NurzhanSeitzhanov/Not-a-Drone_Big-Data/README.md

# Not a Drone – Brand­erkennungs­prototyp

Dieses Projekt ist ein Prototyp auf Basis eines **ESP32-S3 Mikrocontrollers**, der eine Kamera, eine LED und einen Motor kombiniert, um feuerähnliche Farben zu erkennen. Das System bietet eine visuelle Rückmeldung über die LED, eine mechanische Reaktion durch den Motor sowie eine detaillierte Ausgabe über die serielle Schnittstelle.

---

## Wichtiger Hinweis

Damit der Code korrekt funktioniert, müssen **alle Dateien aus dem `code` Ordner gemeinsam in einem Arduino-Sketch-Ordner** verwendet werden.  
Es reicht nicht aus, nur die `.ino`-Datei hochzuladen, da die zusätzlichen `.h`- und `.cpp`-Dateien zwingend erforderlich sind.  

Eine ausführliche Beschreibung der Implementierung, Konfiguration und Hardware befindet sich in der **Projektdokumentation** im Ordner `Dokumentation`.
